TechhouseDragon/NC-1-/PCB/Button/Project Outputs for button/BOM/Bill of Materials-button.xls

Description | Designator | Comment | Value | Footprint | Quantity | Supplier 1 | Supplier Part Number 1 | Pricing 1 | Manufacturer 1 | Manufacturer Part Number 1
CAP CER 0.1UF 50V X5R 0603 | CL1, CL2, CL3, CL4, CL5, CL6, CL7, CL8, CL9, CL10 | 603 | 0.1uF | C0603 | 10 | Digi-Key | 311-4046-1-ND | 1=0.10000, 10=0.05600, 50=0.03080, 100=0.02510, 500=0.01794, 1000=0.01410 (USD) | Yageo | CC0603KRX5R9BB104
Pushbutton Switch SPDT Keyswitch, Illuminated Through Hole | PAT1, PAT2, PAT3, PAT4, PAT5, PAT6, PAT7, PAT8, PAT9, PAT10 | 55?-2LED01 |  | 5501-2LED | 10 | Digi-Key | EG171571-ND | 1=5.08000, 10=4.53000, 25=4.28800, 50=4.13420, 100=3.93620, 250=3.76028, 500=3.43044, 1000=3.25452 (USD) | E-Switch | 5501MBLKREDGRN
RES SMD 330 OHM 1% 1/10W 0603 | RL1, RL2, RL3, RL4, RL5, RL6, RL7, RL8, RL9, RL10, RL11, RL12, RL13, RL14, RL15, RL16, RL17, RL18, RL19, RL20 | 603 | 330 | R0603 | 20 | Digi-Key | 311-330HRCT-ND | 1=0.10000, 10=0.02300, 100=0.00940, 1000=0.00421, 2500=0.00366 (USD) | Yageo | RC0603FR-07330RL
