TechhouseDragon/NC-1-/PCB/STROBE/Project Outputs for Strobe/BOM/Bill of Materials-Strobe.xls

Description | Designator | Comment | Value | Footprint | Quantity | Supplier 1 | Supplier Part Number 1 | Pricing 1 | Manufacturer 1 | Manufacturer Part Number 1
Pushbutton Switch SPST-NO Standard, Illuminated Through Hole | BTN | KP0115ANBKG03RGB-2SJB |  | KP0115ANBKG03RGB-2SJB | 1 | Digi-Key | 360-2465-ND | 1=20.27000, 10=18.40500, 25=17.57800, 50=16.64740, 100=16.02700, 250=14.99300, 500=12.40800 (USD) | NKK Switches | KP0115ANBKG03RGB-2SJB
CAP CER 0.1UF 50V X5R 0603 | C1 | 603 | 0.1uF | C0603 | 1 | Digi-Key | 311-4046-1-ND | 1=0.10000, 10=0.05600, 50=0.03080, 100=0.02510, 500=0.01794, 1000=0.01410 (USD) | Yageo | CC0603KRX5R9BB104
CONN HEADER VERT 6POS 2.54MM | P | Header 6 |  | Molex HDR1X6 | 1 | Digi-Key | WM4204-ND | 1=0.43000, 10=0.40300, 100=0.28180, 500=0.24150, 1000=0.20125, 5000=0.17250, 10000=0.16100 (USD) | Molex | 22-23-2061
RES SMD 330 OHM 1% 1/10W 0603 | R1 | 603 | 330 | R0603 | 1 | Digi-Key | 311-330HRCT-ND | 1=0.10000, 10=0.02300, 100=0.00940, 1000=0.00421, 2500=0.00366 (USD) | Yageo | RC0603FR-07330RL
