TechhouseDragon/NC-1-/PCB/Toggle/Project Outputs for Toggle/BOM/Bill of Materials-Toggle.xls

Description | Designator | Comment | Value | Footprint | Quantity | Supplier 1 | Supplier Part Number 1 | Pricing 1 | Manufacturer 1 | Manufacturer Part Number 1
CONN HEADER VERT 3POS 2MM | P | Header 3 |  | B3B-PH-K-S(LF)(SN) | 1 | Digi-Key | 455-1705-ND | 1=0.19000, 10=0.18200, 100=0.12620, 500=0.10676, 1000=0.08736, 5000=0.07765, 10000=0.07037 (USD) | JST | B3B-PH-K-S(LF)(SN)
SWITCH TOGGLE SPDT 6A 125V | TOGGLE | 5636AB9 |  | 320-916 | 1 | Mouser | 642-5636A9 | 1=8.04000, 25=7.62000, 50=7.19000, 100=6.98000, 250=5.92000, 500=5.71000 (USD) | APEM | 5636A9
