TechhouseDragon/NC-1-/PCB/LEDController_NC-1/Project Outputs for LEDController_NC-1/BOM/Bill of Materials-LEDController_NC-1.xls

Description | Designator | Comment | Value | Footprint | Quantity | Supplier 1 | Supplier Part Number 1 | Pricing 1 | Manufacturer 1 | Manufacturer Part Number 1 | Supplier Unit Price 1 | Manufacturer Part Number | Manufacturer
CONN HEADER VERT 8POS 2.54MM | AD_H | AD_H |  | Header 8x1 8.5mm | 1 | Digi-Key | S1212EC-08-ND | 1=0.22000, 10=0.20200, 25=0.17200, 50=0.15060, 100=0.13980, 250=0.12364, 500=0.11828 (USD) | Sullins | PREC008SFAN-RC | 0.22
CONN HEADER VERT 8POS 2.54MM | AD_L | AD_L |  | Header 8x1 8.5mm | 1 | Digi-Key | S1212EC-08-ND | 1=0.22000, 10=0.20200, 25=0.17200, 50=0.15060, 100=0.13980, 250=0.12364, 500=0.11828 (USD) | Sullins | PREC008SFAN-RC | 0.22
CONN HEADER VERT 3POS 2MM | BLACKOUT, COLOR_MODE | Header 3 |  | B3B-PH-K-S(LF)(SN) | 2 | Digi-Key | 455-1705-ND | 1=0.19000, 10=0.18200, 100=0.12620, 500=0.10676, 1000=0.08736, 5000=0.07765, 10000=0.07037 (USD) | JST | B3B-PH-K-S(LF)(SN) | 0.19
CAP CER 0.1UF 50V X5R 0603 | CB1, CL11, CL12, CL13, CR1, CR2, CR3 | 603 | 0.1uF | C0603 | 7 | Digi-Key | 311-4046-1-ND | 1=0.10000, 10=0.05600, 50=0.03080, 100=0.02510, 500=0.01794, 1000=0.01410 (USD) | Yageo | CC0603KRX5R9BB104 | 0.1
CONN HEADER VERT 8POS 2.54MM | COMMS | Communication |  | Header 8x1 8.5mm | 1 | Digi-Key | S1212EC-08-ND | 1=0.22000, 10=0.20200, 25=0.17200, 50=0.15060, 100=0.13980, 250=0.12364, 500=0.11828 (USD) | Sullins | PREC008SFAN-RC | 0.22
CAP ALUM 220UF 20% 35V SMD | CP1, CP2, CP3, CP4 | Cap Pol | 220uF | Cap10x10 | 4 | Digi-Key | 4427PHCT-ND | 1=2.42000, 10=1.95700, 50=1.70800, 100=1.49460 (USD) | Vishay BCcomponents | MAL214699004E3 | 2.53
CONN HEADER VERT 36POS 2.54MM | DIGITAL | IO_36 |  | HEADER 36X 8MM | 1 | Digi-Key | S2212EC-18-ND | 1=0.77000, 10=0.72600, 25=0.65320, 50=0.58060, 100=0.55640, 250=0.50804, 500=0.48384 (USD) | Sullins | PREC018DFAN-RC | 0.77
DIODE SCHOTTKY 40V 3A SOD123FA | DP1, DP2 | SS34FA |  | SOD_34FA_ONS | 2 | Digi-Key | SS34FACT-ND | 1=0.35000, 10=0.28200, 25=0.25800, 100=0.16200, 500=0.15000, 1000=0.10200 (USD) | ON Semiconductor / Fairchild | SS34FA | 0.49
 | ICSP | ICSP |  | ICSP | 1
2.0 x 6.0 mm, 5.0 A, Horizontal, Through Hole, Pick-n-Place Top, Dc Power Jack Connector | JIN | PJ-050AH |  | CUI_PJ-050AH | 1 | Digi-Key | CP-050AH-ND | 1=0.78000, 10=0.68900, 25=0.64800, 50=0.62100, 100=0.59400, 250=0.54000, 500=0.48600, 1000=0.43200, 2500=0.39150 (USD) | CUI | PJ-050AH | 0.79
LED RED DIFFUSED T-1 3/4 T/H | LED1, LED2, LED3, LED4, LED5, LED6, LED7, LED8, LED9, LED10, LED11, LED12, LED13, LED14, LED15, LED16, LED17, LED18, LED19, LED20 | LED 3mm |  | LED3mm | 20 | Digi-Key | 754-1264-ND | 1=0.48000, 10=0.34200, 100=0.15200, 500=0.10640, 1000=0.08740, 2500=0.07600, 5000=0.06840, 10000=0.06080, 25000=0.05700 (USD) | Kingbright | WP7113ID | 0.278
Amber 605nm LED Indication - Discrete 2V 0603 (1608 Metric) | LEDP1, LEDP2, LEDP3, LEDP4, LEDP5, LEDP6, LEDP7 | 150060AS75000 |  | LED-0603-Amber | 7 | Digi-Key | 732-150060AS75000CT-ND | 1=0.14000, 50=0.13300, 100=0.11400, 500=0.09900 (USD) | Wurth Electronics | 150060AS75000 | 0.14
FIXED IND 47UH 3.8A 60 MOHM SMD | LP1, LP2 | 12x12mm | 47uH | 12x12mmInductor | 2 | Digi-Key | 732-1246-1-ND | 1=2.41000, 10=2.20000, 50=2.07000, 100=1.94000 (USD) | Wurth Electronics | 7447709470 | 2.41
CONN HEADER VERT 12POS 2.54MM | P1 | Header 12 |  | 12Pos Header | 1 | Digi-Key | S1212EC-12-ND | 1=0.30000, 10=0.28200, 25=0.24200, 50=0.20560, 100=0.19760, 250=0.17740, 500=0.16934 (USD) | Sullins | PREC012SFAN-RC | 0.3
CONN HEADER VERT 10POS 2.54MM | P2, P3 | Header 10 |  | 10POS HEADER | 2 | Digi-Key | S1212EC-10-ND | 1=0.27000, 10=0.25200, 25=0.21520, 50=0.18820, 100=0.17470, 250=0.15456, 500=0.14784 (USD) | Sullins | PREC010SFAN-RC | 0.27
CONN HEADER VERT 6POS 2.54MM | P_JUMPER | Header 3X2 |  | HDR2X3 | 1 | Digi-Key | S2212EC-03-ND | 1=0.16000, 10=0.15100, 25=0.12920, 50=0.11280, 100=0.10480, 250=0.09272, 500=0.08870 (USD) | Sullins | PREC003DFAN-RC | 0.16
CONN HEADER VERT 6POS 2.54MM | P_LED1 | Header 6 |  | HDR1X6 | 1 | Digi-Key | S1212EC-06-ND | 1=0.16000, 10=0.15100, 25=0.12920, 50=0.11280, 100=0.10480, 250=0.09272, 500=0.08870 (USD) | Sullins | PREC006SFAN-RC | 0.16
CONN MOD JACK 6P6C R/A UNSHLD | P_LED2 | E5566-Q0LK22-L |  | E5566Q0LK22L | 1 | Digi-Key | 553-2258-ND | 1=0.54000, 10=0.51000, 25=0.45920, 50=0.40800, 100=0.39100, 250=0.35700, 500=0.34000, 1000=0.28050, 2500=0.25500 (USD) | Pulse | E5566-Q0LK22-L | 0.58
Pushbutton Switch SPST-NO Standard, Illuminated Through Hole | Pallete | KP0115ANBKG03RGB-2SJB |  | KP0115ANBKG03RGB-2SJB | 1 | Digi-Key | 360-2465-ND | 1=20.27000, 10=18.40500, 25=17.57800, 50=16.64740, 100=16.02700, 250=14.99300, 500=12.40800 (USD) | Nihon Kaiheiki | KP0115ANBKG03RGB-2SJB | 20.47
TERMINAL BLOCK, SCREW TYPE, 5.08 | PIN | Header 2 |  | 5.08mmScrew | 1 | Digi-Key | 102-6203-ND | 1=0.73000, 10=0.39800, 25=0.29760, 50=0.26520, 100=0.26000, 250=0.22880, 500=0.20800, 1000=0.18720, 5000=0.14040 (USD) | CUI | TB007-508-02BE | 0.79
CONN HEADER VERT 6POS 2.54MM | POWER | POWER |  | Header 6x1 8.5mm | 1 | Digi-Key | S1212EC-06-ND | 1=0.16000, 10=0.15100, 25=0.12920, 50=0.11280, 100=0.10480, 250=0.09272, 500=0.08870 (USD) | Sullins | PREC006SFAN-RC | 0.16
Red, Yellow 617nm Red, 588nm Yellow LED Indication - Discrete 2V Red, 2.1V Yellow Radial - 3 Leads | POWER_INDICATOR | WP59EYW |  | DUOLED-C-5MM | 1 | Digi-Key | 754-1233-ND | 1=0.62000, 10=0.44600, 100=0.29120, 500=0.20930, 1000=0.16380, 2500=0.15015, 5000=0.13650, 10000=0.12740, 25000=0.12285 (USD) | Kingbright | WP59EYW | 0.63
CONN HEADER VERT 8POS 2.54MM | PWM_H | PWM_H |  | Header 8x1 8.5mm | 1 | Digi-Key | S1212EC-08-ND | 1=0.22000, 10=0.20200, 25=0.17200, 50=0.15060, 100=0.13980, 250=0.12364, 500=0.11828 (USD) | Sullins | PREC008SFAN-RC | 0.22
CONN HEADER VERT 8POS 2.54MM | PWM_L | PWM_L |  | Header 8x1 8.5mm | 1 | Digi-Key | S1212EC-08-ND | 1=0.22000, 10=0.20200, 25=0.17200, 50=0.15060, 100=0.13980, 250=0.12364, 500=0.11828 (USD) | Sullins | PREC008SFAN-RC | 0.22
Bipolar (BJT) Transistor NPN 25V 1.5A 100MHz 300mW Surface Mount SOT-23 | Q1 | SS8050-G |  | TRAN_SS8050-G_CIP | 1 | Digi-Key | 641-1790-1-ND | 1=0.21000, 10=0.17400, 25=0.14600, 100=0.07130, 500=0.05946, 1000=0.04131 (USD) | Comchip | SS8050-G | 0.26
Potentiometers Sgl Unit Vert Flat Snap-in 10K Ohms 20% | R1, R2, R3, R4, R5, R6, R7, R8 | RK09L1140A2U |  | EVUFXM | 8 | Mouser | 688-RK09L1140A2U | 1=1.49000, 25=1.31000, 50=1.23000, 100=1.19000, 500=1.10000, 1000=1.07000 (USD) | Alps Electric | RK09L1140A2U | 1.49
RES SMD 330 OHM 1% 1/10W 0603 | RB1, RL22, RL23, RP1, RP2, RP3, RP4, RP5, RP6, RP7, RR21, RR22, RR23, RR24, RR25, RR26, RR27, RR28, RR29, RR30, RR31, RR32, RR33, RR34, RR35, RR36, RR37, RR38, RR39, RR40 | 603 | 330 | R0603 | 30 | Digi-Key | 311-330HRCT-ND | 1=0.10000, 10=0.02300, 100=0.00940, 1000=0.00421, 2500=0.00366 (USD) | Yageo | RC0603FR-07330RL | 0.024
RES SMD 10K OHM 5% 1/10W 0603 | RL24, RL25, RL26, RL27, RL28, RL29 | 603 | 10K | R0603 | 6 | Digi-Key | 311-10KGRCT-ND | 1=0.10000, 10=0.01900, 100=0.00770, 1000=0.00347, 2500=0.00301 (USD) | Yageo | RC0603JR-0710KL | 0.1
Switch Rotary SP Flatted Shaft PC Pins 0.2A 115VAC 30VDC | ROTARY1, ROTARY2 | 56DP36-01-1-AJN |  | 56DP36-01-1-AJN | 2 | Digi-Key | GH7281-ND | 1=12.16000, 5=10.45800, 10=9.77800, 25=8.96720, 50=8.36600, 100=7.84320, 250=7.29600 (USD) | Grayhill | 56DP36-01-1-AJN | 12.16
RES SMD 1K OHM 1% 1/10W 0603 | RP, RR1, RR2, RR3, RR4, RR5, RR6, RR7, RR8, RR9, RR10, RR11, RR12, RR13, RR14, RR15, RR16, RR17, RR18, RR19, RR20 | 603 | 1K | R0603 | 21 | Digi-Key | 311-1.00KHRDKR-ND | 1=0.10000, 10=0.02300, 100=0.00940, 1000=0.00421, 2500=0.00366 (USD) | Mepco Philips | RC0603FR-071KL | 0.024 | RC0603FR-071KL | Yageo
CONN HEADER VERT 4POS 2.54MM | SP_SELECTOR | SPEEDSELECTOR |  | HDR1X4 | 1 | Digi-Key | S1212EC-04-ND | 1=0.13000, 10=0.12600, 25=0.09400, 50=0.08060, 100=0.07800, 250=0.06720, 500=0.06452 (USD) | Sullins | PREC004SFAN-RC | 0.13
Connector Header Through Hole 2 position 0.079" (2.00mm) | STROBE | STROBE |  | JST_B2B-PH-K-S(LF)(SN) | 1 | Newark | 37K9940 | 1=0.183000, 10=0.172000, 100=0.123000, 500=0.104000, 1000=0.087000, 5000=0.075000 (USD) | JST | B2B-PH-K-S(LF)(SN) | 0.227
Counter Shift Registers 8-Bit Shift Register | U1, U2, U3, U4, U5, U6 | SN74HC595NE4 |  | DIP794W53P254L1930H508Q16N | 6 | Digi-Key | 296-36142-5-ND | 1=0.57000, 10=0.48800, 25=0.45520, 100=0.36400, 250=0.33800, 500=0.28600, 1000=0.22100, 2500=0.20150, 5000=0.18850 (USD) | Texas Instruments | SN74HC595NE4 | 0.65
Buck Switching Regulator IC Positive Fixed 5V 1 Output 3A TO-263-6, D²Pak (5 Leads + Tab), TO-263BA | U7 | LM2596SX-5.0/NOPB | Value | TS5B | 1 | Digi-Key | LM2596SX-5.0/NOPBCT-ND | 1=4.91000, 10=4.41300, 25=4.17160, 100=3.42990, 250=3.07764 (USD) | TI National Semiconductor | LM2596SX-5.0/NOPB | 5.06
Buck Switching Regulator IC Positive Fixed 12V 1 Output 3A TO-263-6, D²Pak (5 Leads + Tab), TO-263BA | U8 | LM2596SX-12.0 |  | TS5B | 1 | Digi-Key | LM2596SX-12/NOPBCT-ND | 1=4.77000, 10=4.28400, 25=4.05000, 100=3.33000, 250=2.98800 (USD) | TI National Semiconductor | LM2596SX-12/NOPB | 5.06
