TechhouseDragon/NC-1-/Enclosure/pcb.DXF

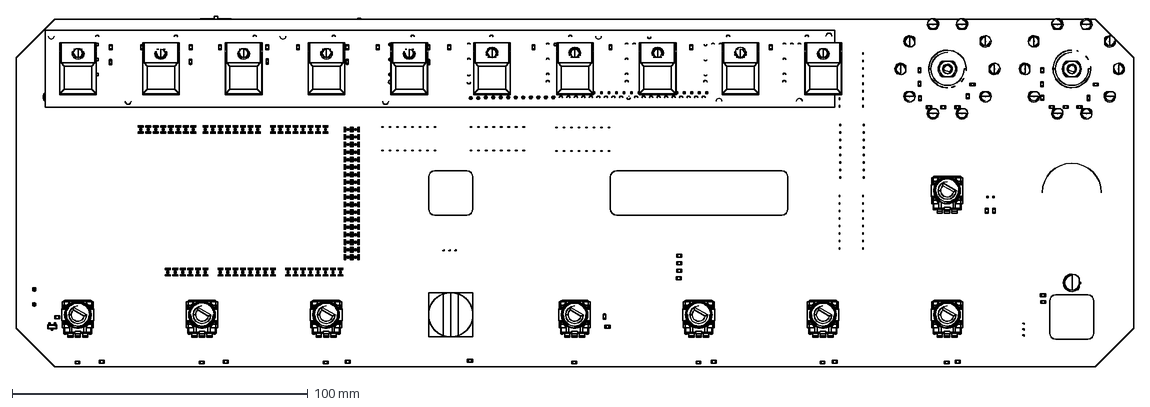
[picture p1: CAD file, 2022-05-18]
Enclosure/pcb.DXF
377.8 x 118.4 mm
