TechhouseDragon/NC-1-/PCB/Button/Project Outputs for button/3D STEP/button.step

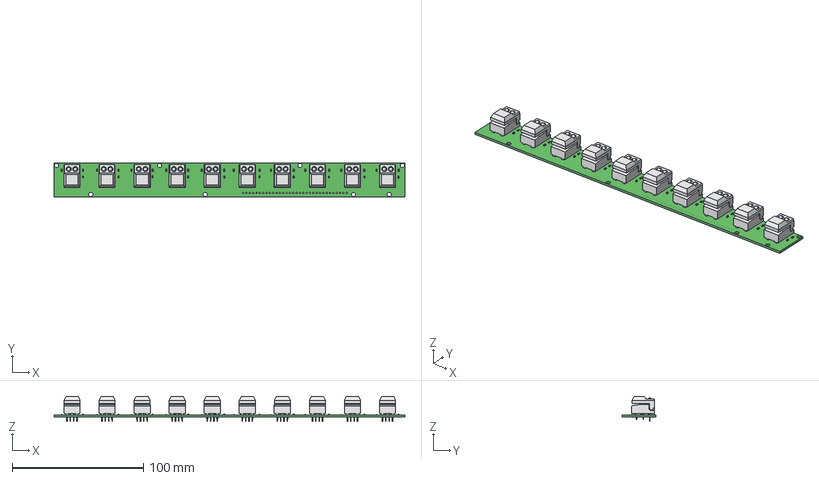
[picture p2: CAD file, 2022-05-08]
PCB/Button/Project Outputs for button/3D STEP/button.step
267.0 x 26.0 x 19.1 mm
RES_0603_(1608_metric) x 20
User_Library-CerCaps_0603 x 10
5501MBLKxxxxxx x 10
