TechhouseDragon/NC-1-/PCB/STROBE/Project Outputs for Strobe/3D STEP/Strobe.step

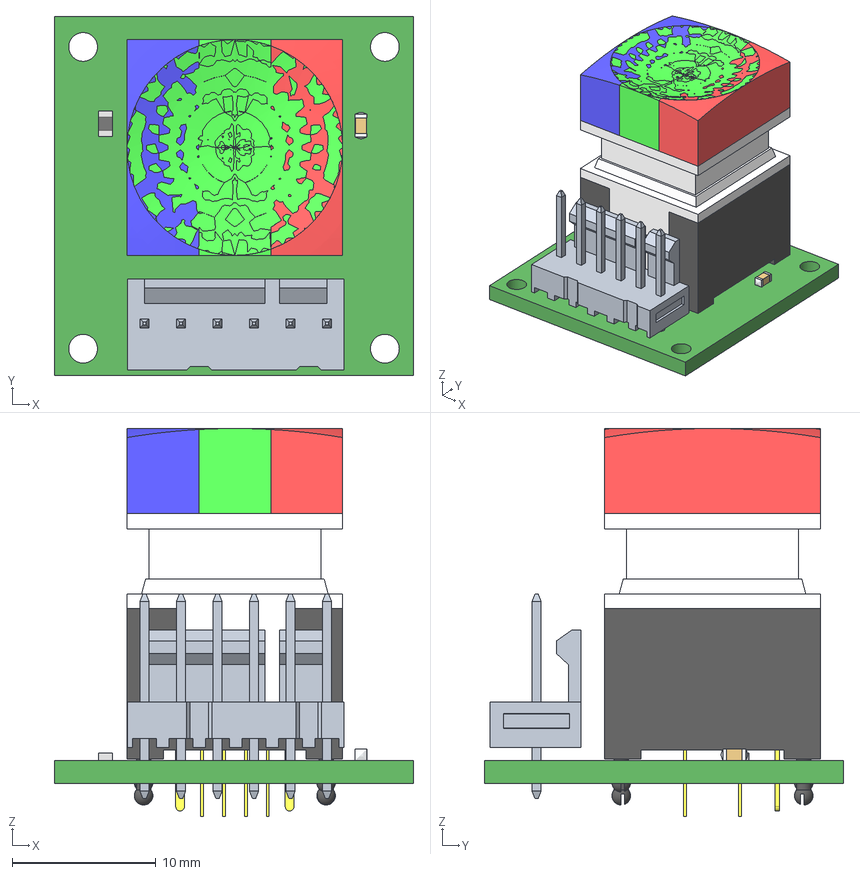
[picture p3: CAD file, 2022-05-08]
PCB/STROBE/Project Outputs for Strobe/3D STEP/Strobe.step
25.0 x 25.0 x 27.0 mm
RES_0603_(1608_metric)
User_Library-CerCaps_0603
_KP0115ANBKG03RGB2S
_kp_standard_coverB
_LED x 2
_LED2 x 8
_AT3079-GREEN-1/3
_AT3079-RED-1/3
_AT3079-BLUE-1/3
_block-2
