TechhouseDragon/NC-1-/PCB/Toggle/Project Outputs for Toggle/3D STEP/Toggle.step

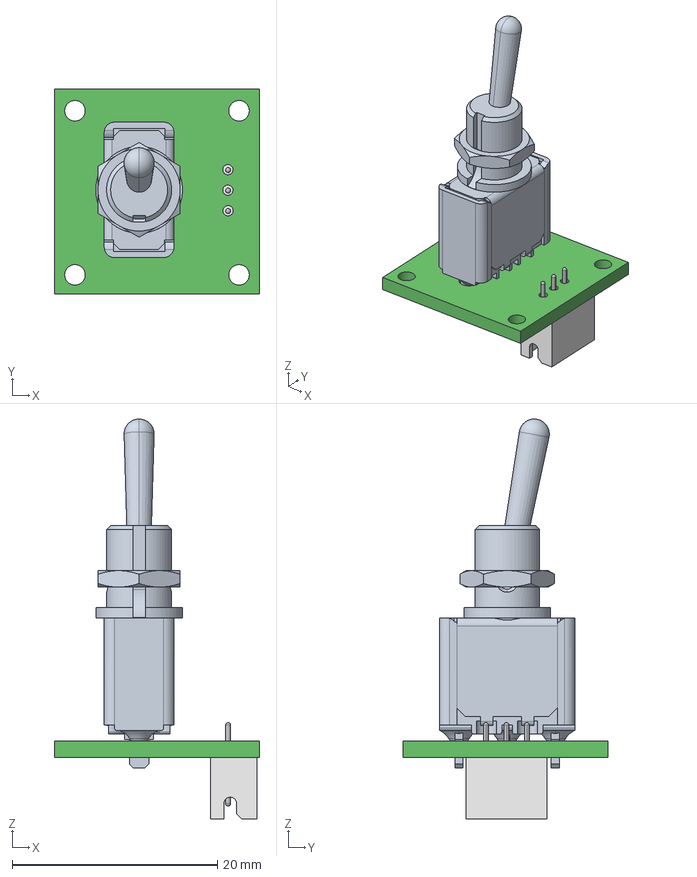
[picture p4: CAD file, 2022-05-08]
PCB/Toggle/Project Outputs for Toggle/3D STEP/Toggle.step
20.0 x 20.0 x 39.0 mm
5636ab
User_Library-B3B-PH-K-S(LF)(SN)
