TechhouseDragon/NC-1-/Enclosure/case.STEP

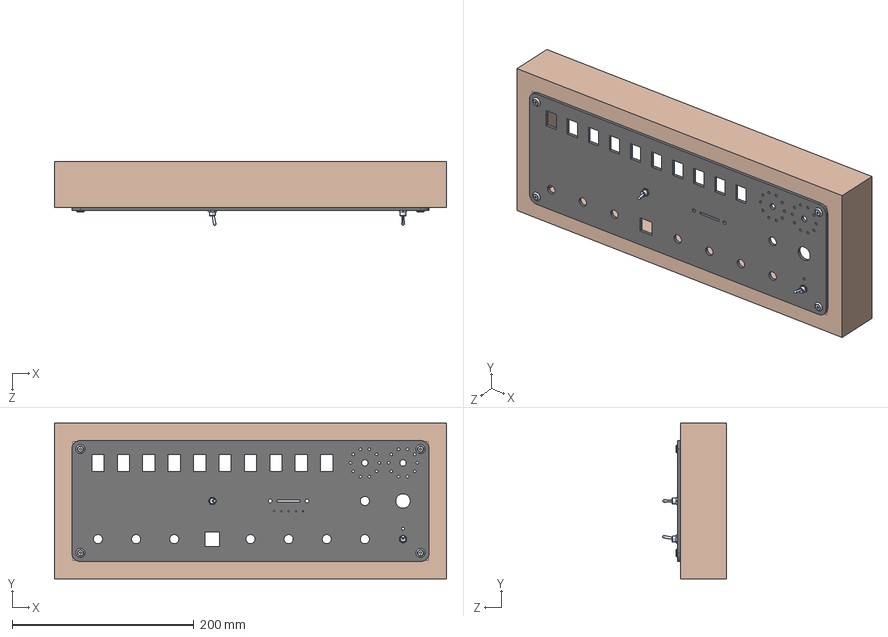
[picture p5: CAD file, 2022-05-18]
Enclosure/case.STEP
431.8 x 171.4 x 70.4 mm
5636ab.STEP x 2
98472A200_TYPE 18-8 STAINLESS STEEL COUNTERSUNK WASHER_98472A200.STEP x 4
92125A130_TYPE 18-8 SS FLAT-HEAD SOCKET CAP SCREW_92125A130.STEP x 4
front_panel_v2_R2.STEP
wood_frame.STEP
