TechhouseDragon/NC-1-/PCB/STROBE/Project Outputs for Strobe/Assembly/Assembly.PDF

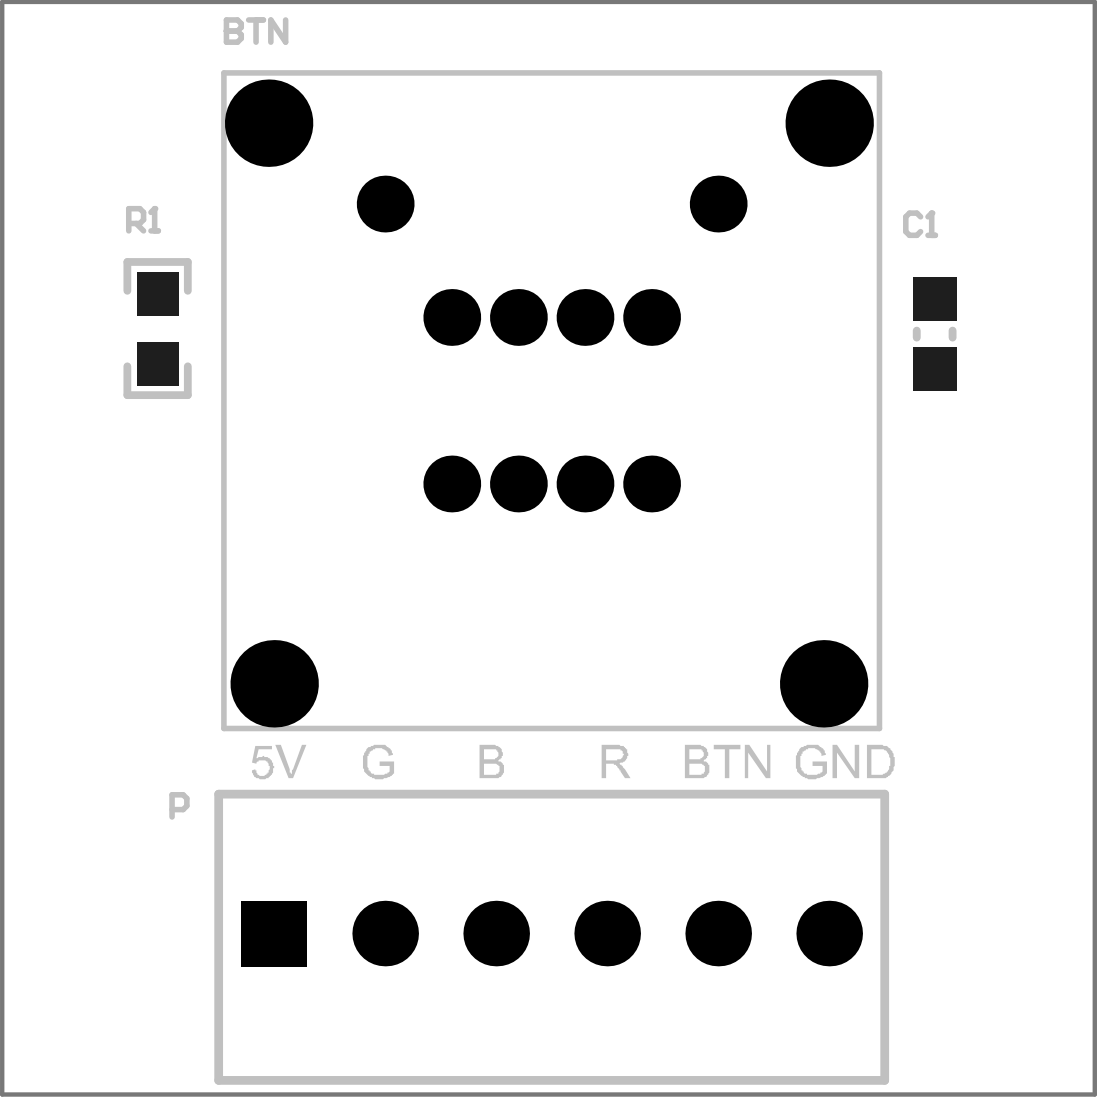
[picture p6: page 1]

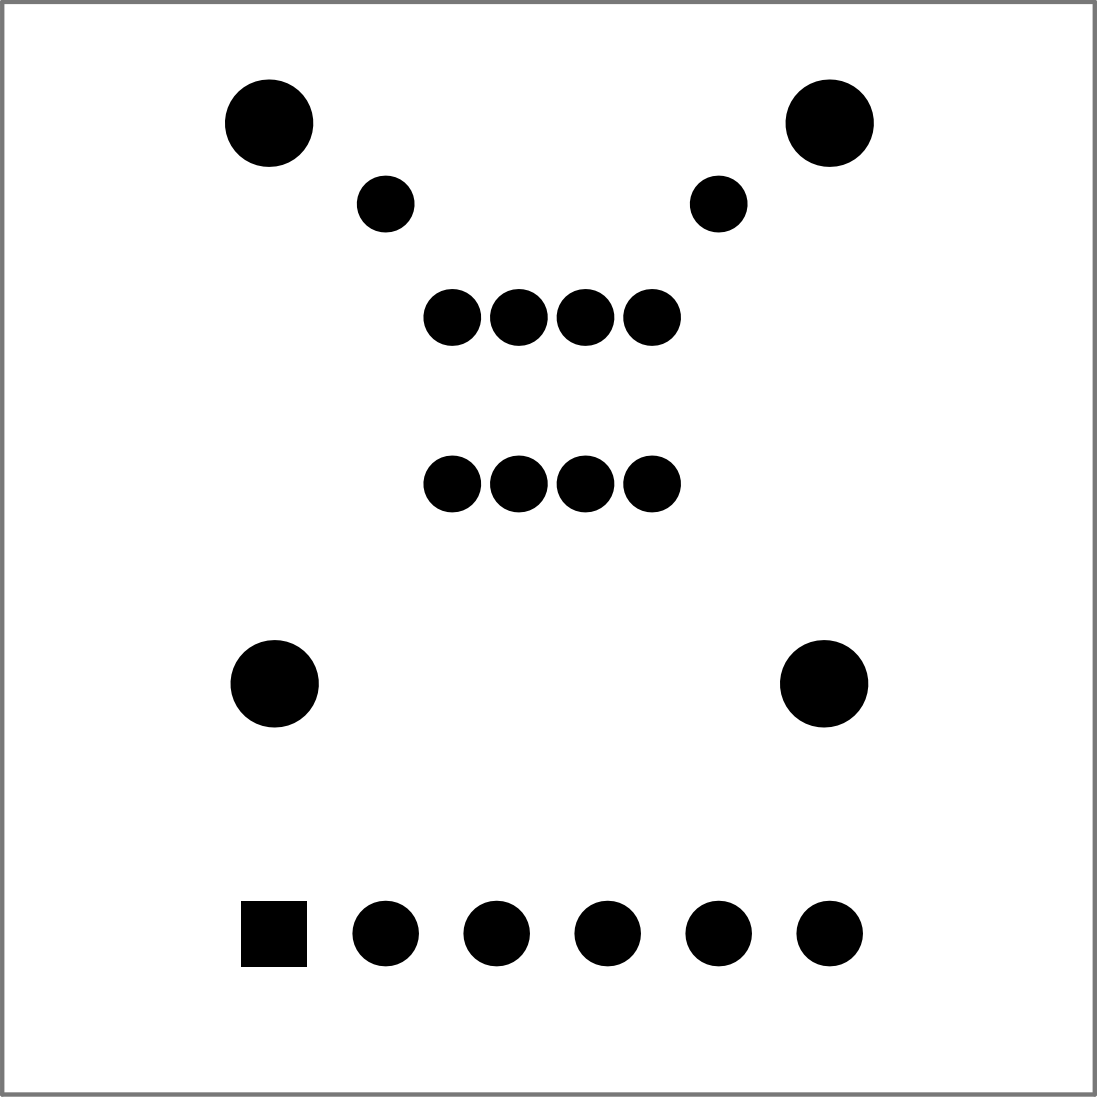
[picture p7: page 2]
