TechhouseDragon/NC-1-/PCB/Toggle/Project Outputs for Toggle/Assembly/Assembly.PDF

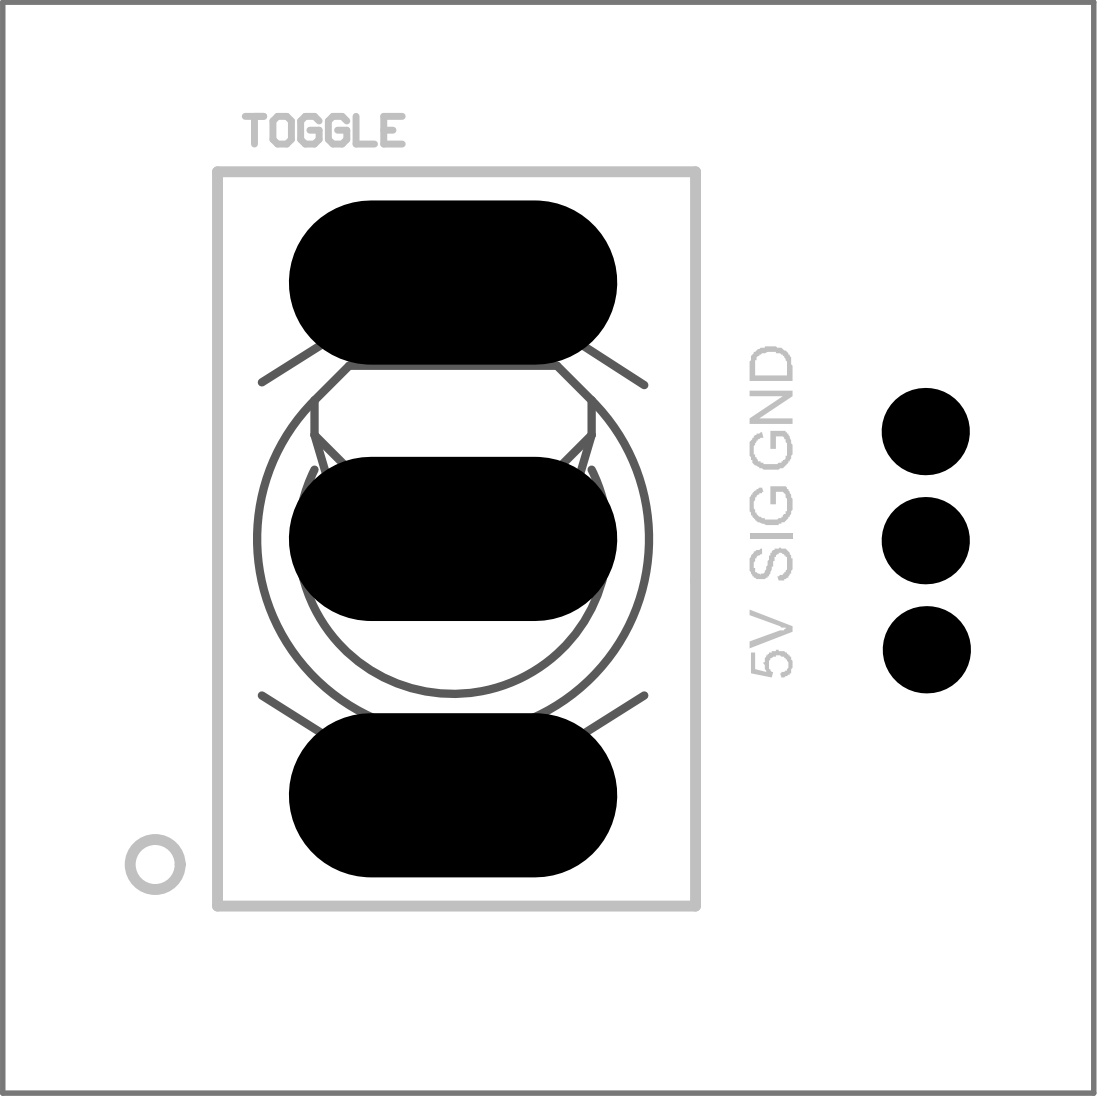
[picture p8: page 1]

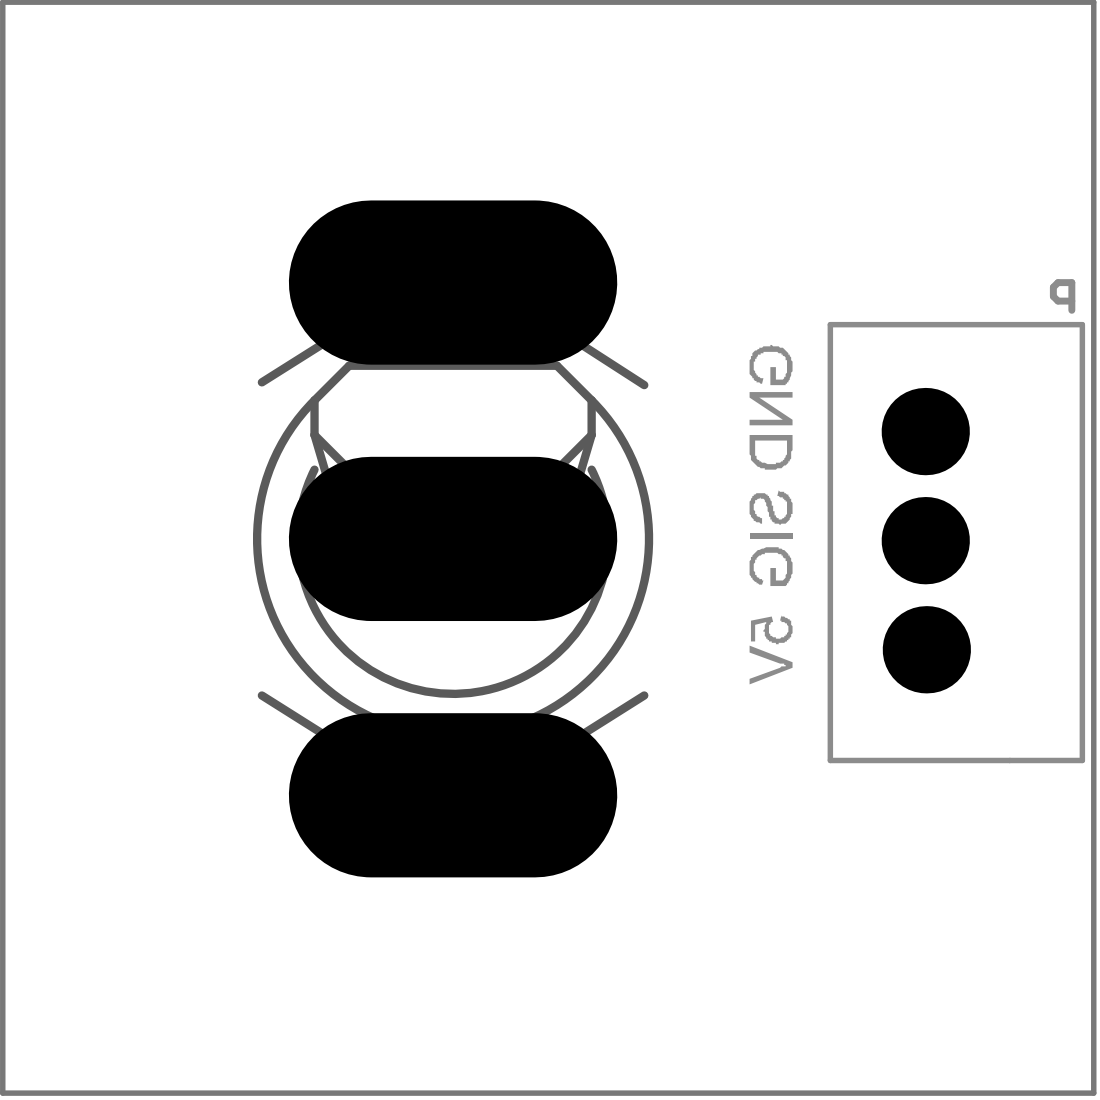
[picture p9: page 2]
