TechhouseDragon/NC-1-/PCB/LEDController_NC-1/Project Outputs for LEDController_NC-1/Assembly/Assembly.PDF

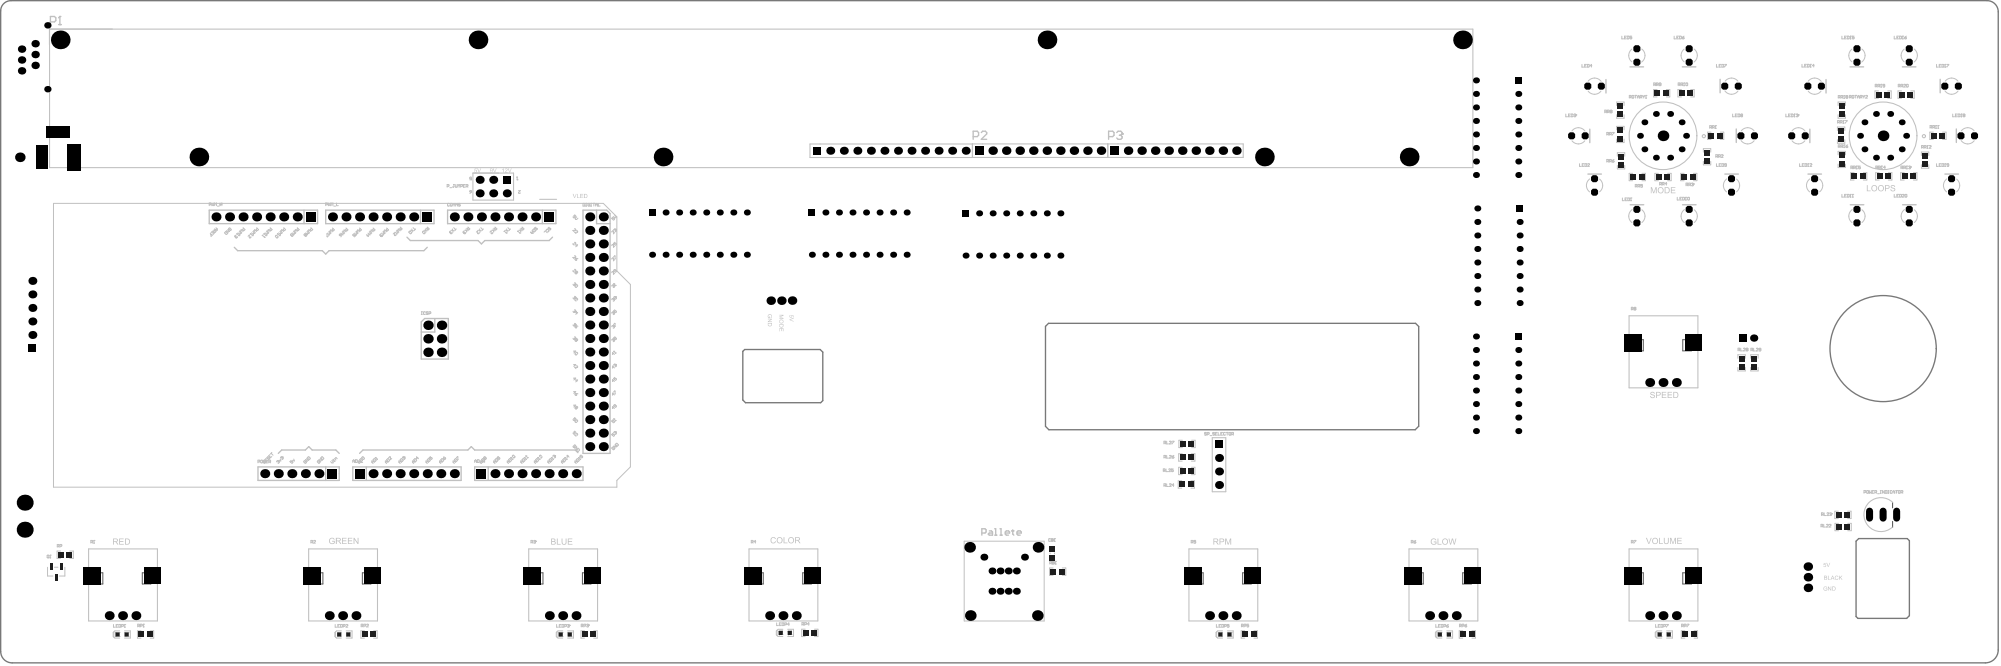
[picture p10: page 1]

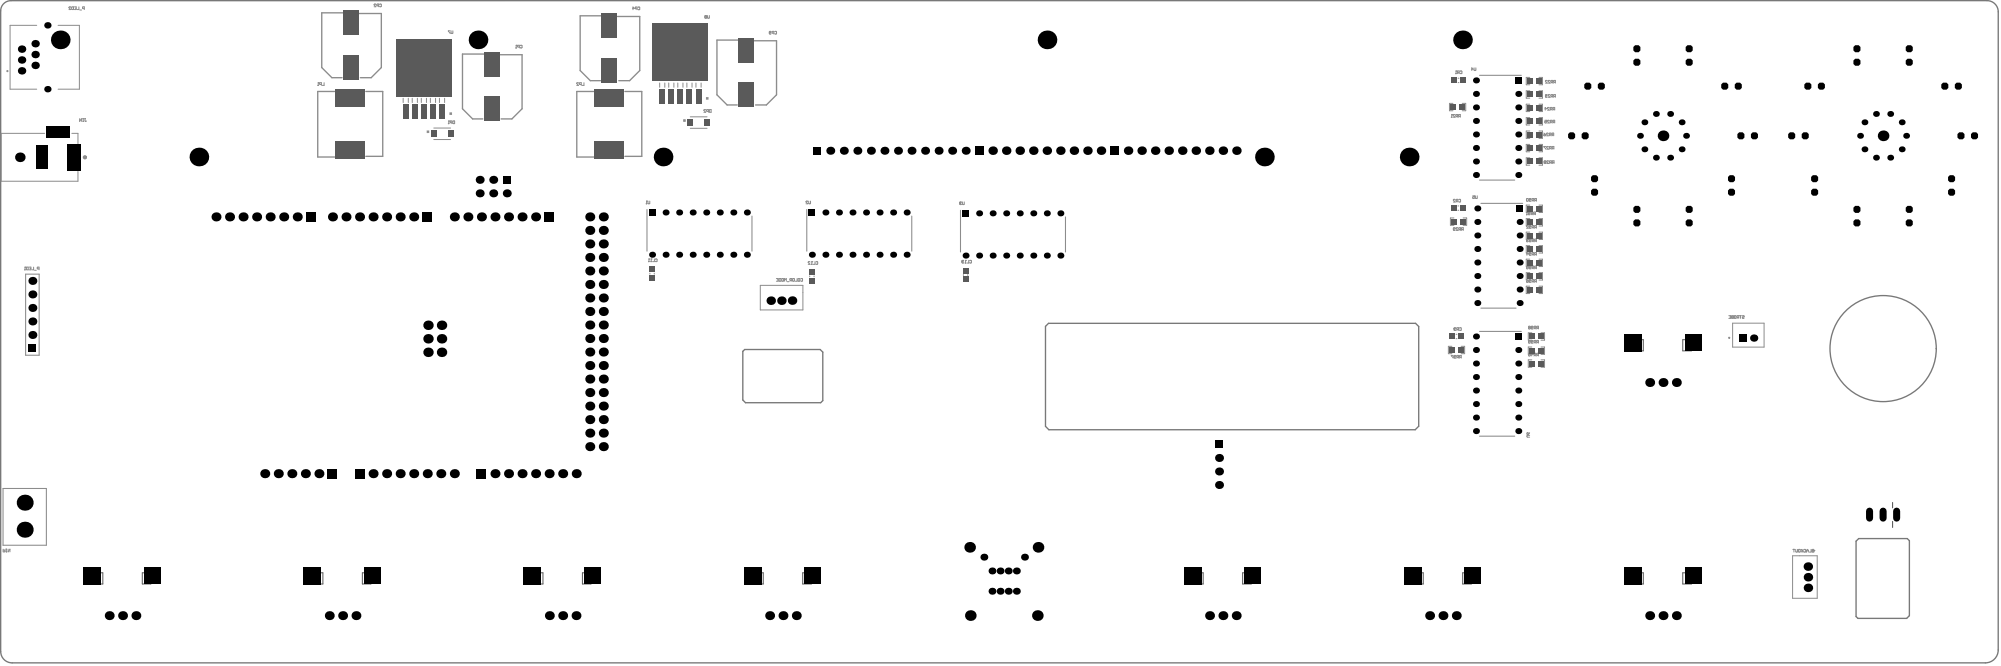
[picture p11: page 2]
