TechhouseDragon/NC-1-/NC_1_Front_Panel_Layout.pdf

## we have the night

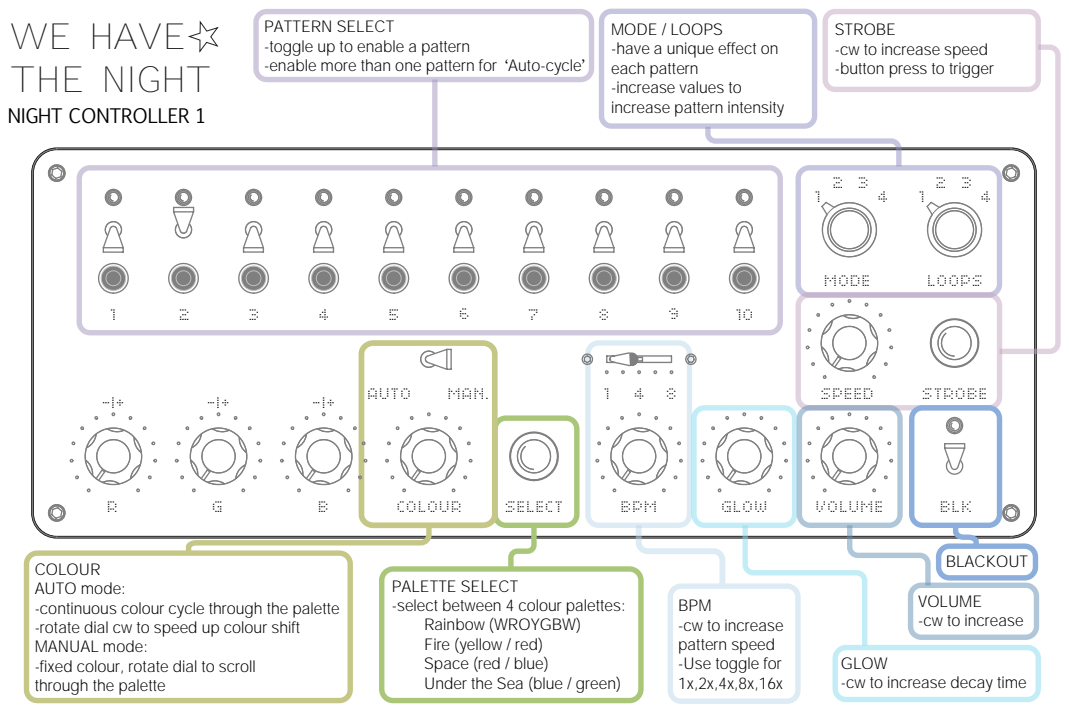
[picture p12: page 1]
COLOUR; SELECT; BPM; GLOW; VOLUME; BLK; MODE; LOOPS; AUTO; MAN. -|+; SPEED; STROBE; NIGHT CONTROLLER 1

PATTERN SELECT
-toggle up to enable a pattern
-enable more than one pattern for ‘Auto-cycle’

MODE / LOOPS
-have a unique effect on
each pattern
-increase values to
increase pattern intensity

STROBE
-cw to increase speed
-button press to trigger

BLACKOUT
VOLUME
-cw to increase

COLOUR
AUTO mode:
-continuous colour cycle through the palette
-rotate dial cw to speed up colour shift
MANUAL mode:
-fixed colour, rotate dial to scroll
through the palette

PALETTE SELECT
-select between 4 colour palettes:
Rainbow (WROYGBW)
Fire (yellow / red)
Space (red / blue)
Under the Sea (blue / green)

BPM
pattern speed
-Use toggle for

GLOW
-cw to increase decay time
