TechhouseDragon/NC-1-/PCB/Button/Project Outputs for button/SCH-PCB-3D Board PDF/SCH-PCB-3D Board.PDF

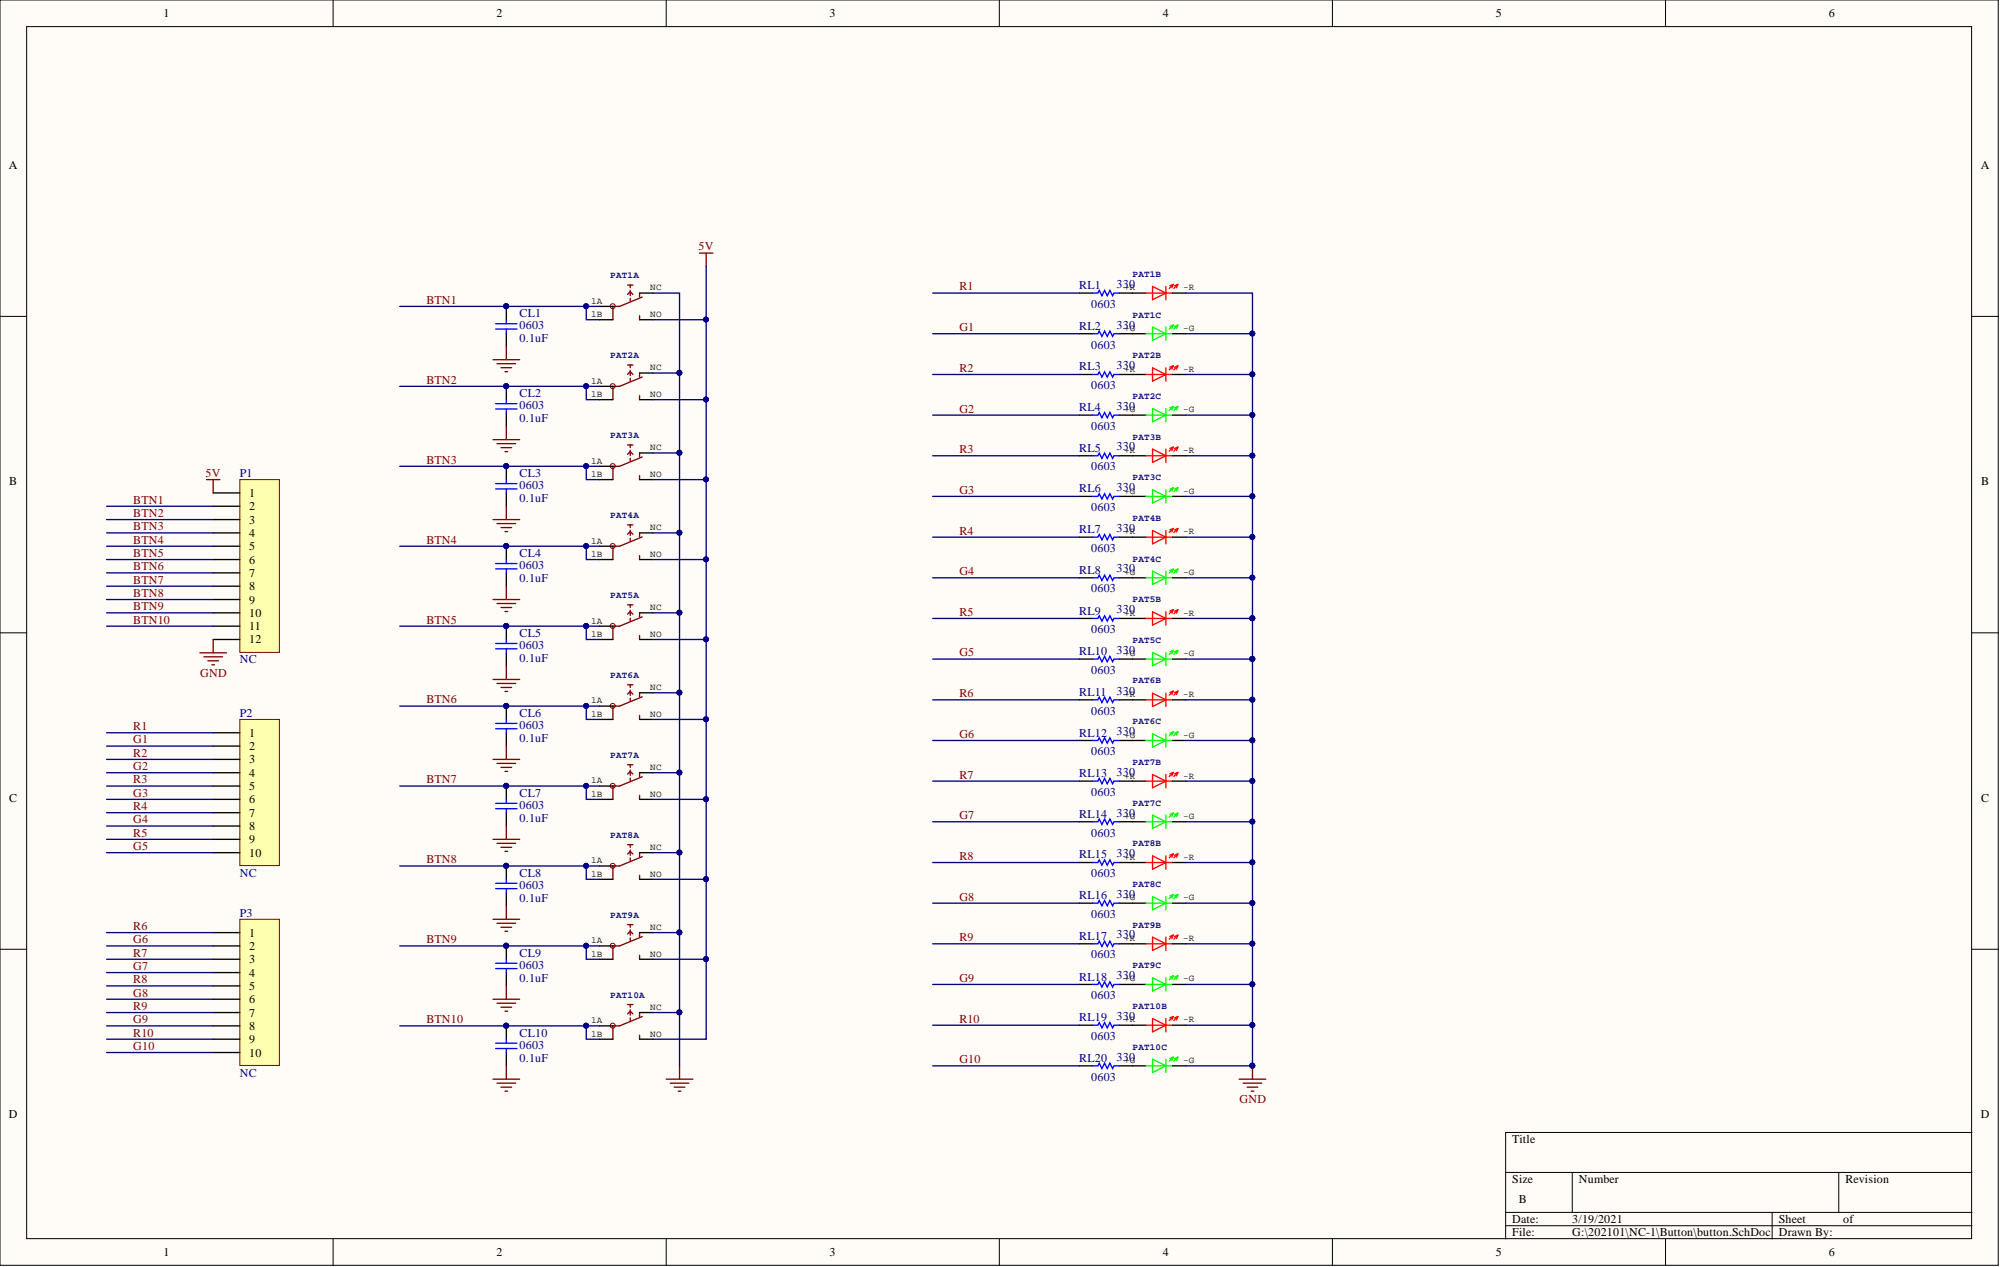
[picture p13: page 1]

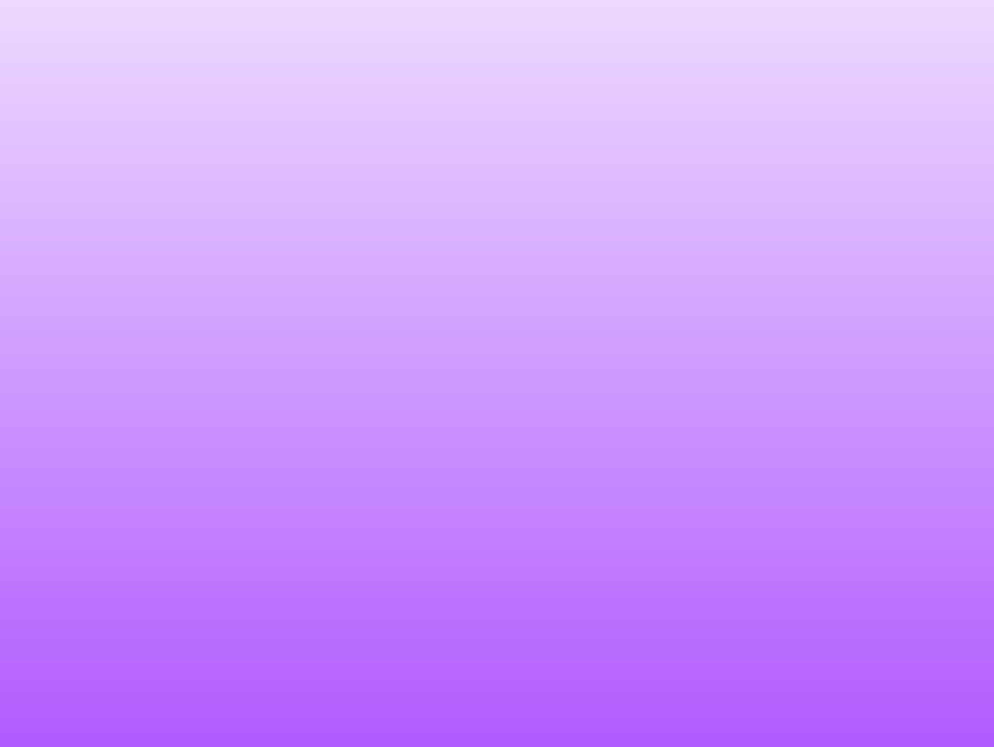
[picture p14: page 3]
