TechhouseDragon/NC-1-/PCB/STROBE/Project Outputs for Strobe/SCH-PCB-3D Board PDF/SCH-PCB-3D Board.PDF

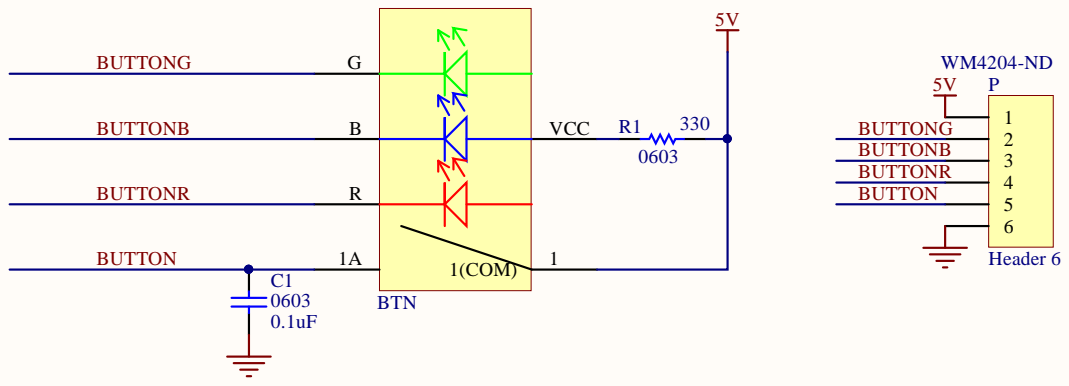
[picture p15: page 1]

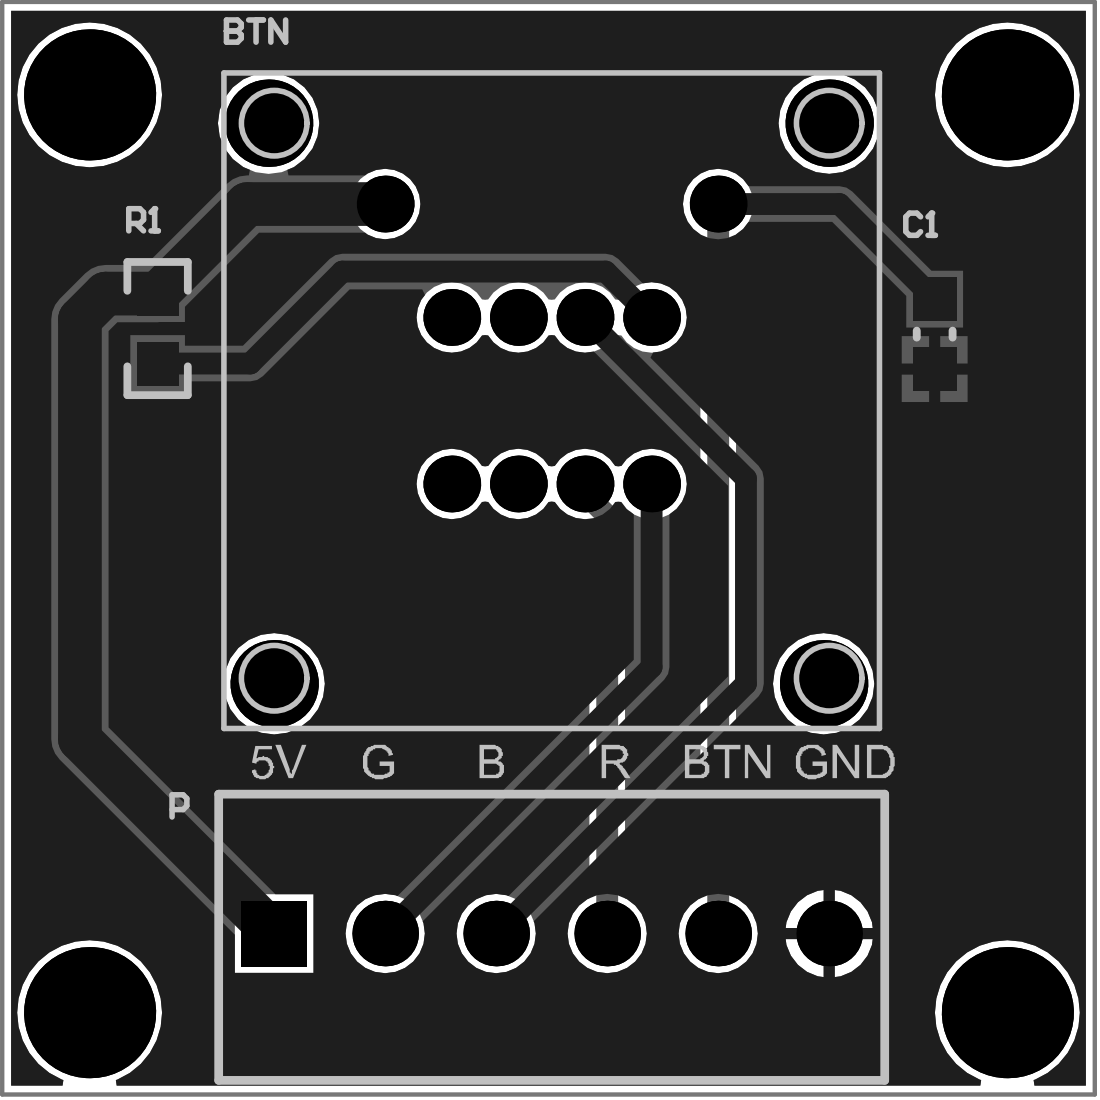
[picture p16: page 2]
