TechhouseDragon/NC-1-/PCB/Toggle/Project Outputs for Toggle/SCH-PCB-3D Board PDF/SCH-PCB-3D Board.PDF

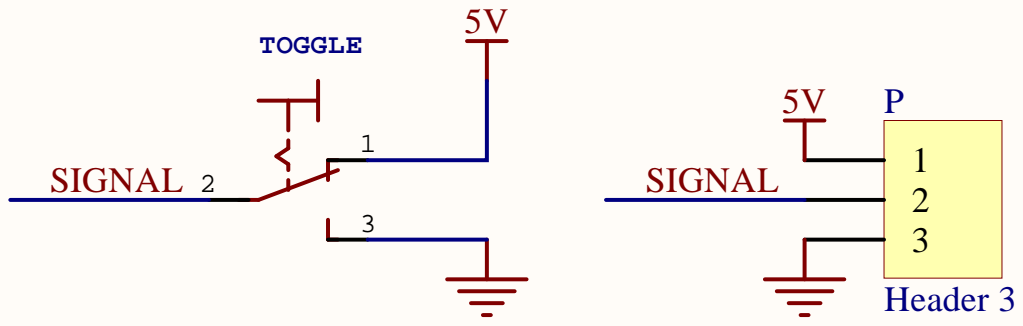
[picture p17: page 1]

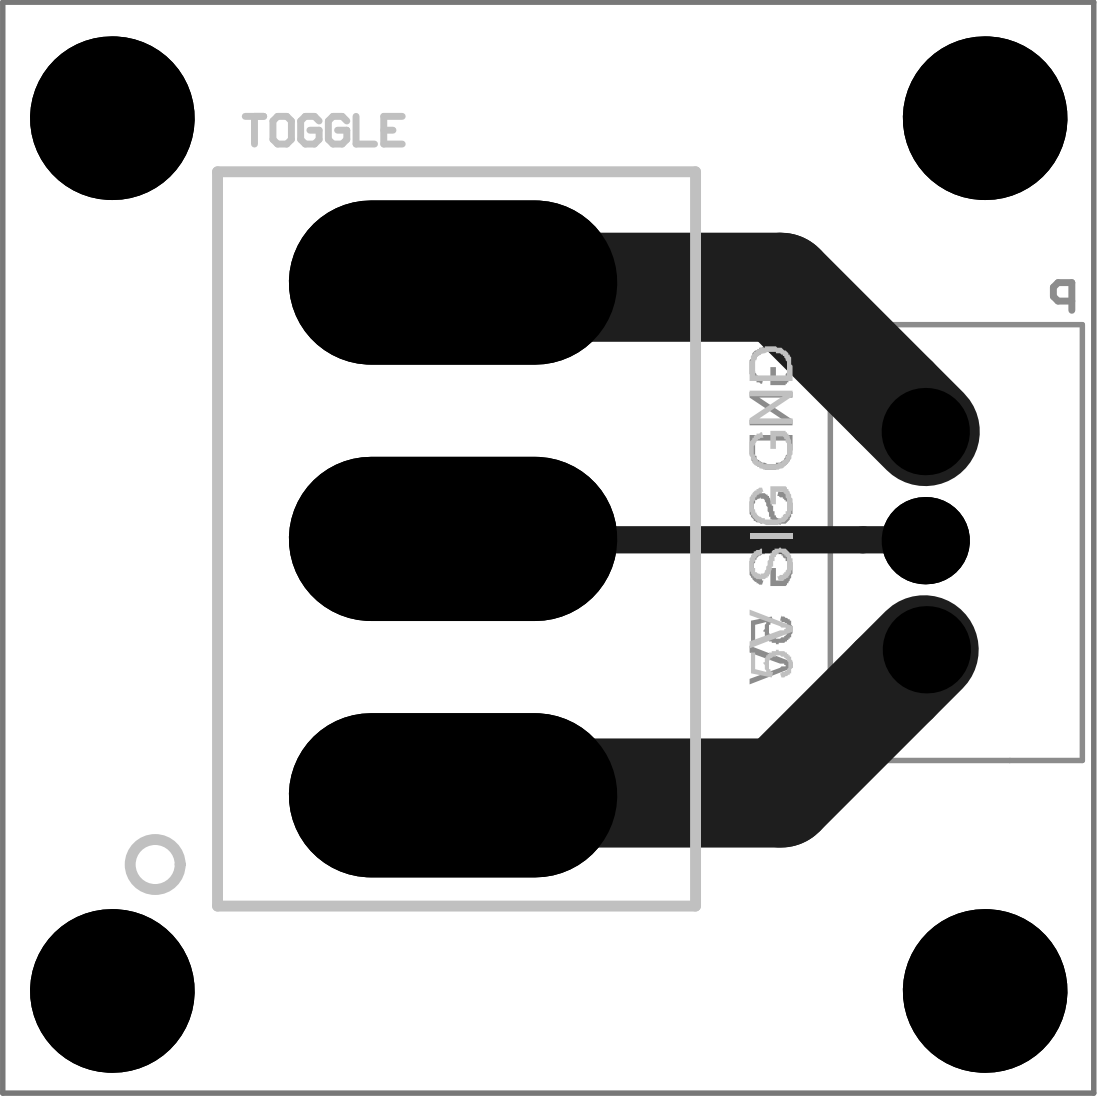
[picture p18: page 2]
