TechhouseDragon/NC-1-/(list of files, drawings)

Other design files:
PCB/Button/button.PcbDoc
PCB/Button/button.PrjPcb
PCB/Button/button.SchDoc
PCB/Button/PcbLib.PcbLib
PCB/Button/Schlib.SchLib
PCB/LEDController_NC-1/LEDController.SchDoc
PCB/LEDController_NC-1/LEDController_NC-1.PrjPcb
PCB/LEDController_NC-1/PcbLib1.PcbLib
PCB/LEDController_NC-1/PcbLib.PcbLib
PCB/LEDController_NC-1/PowerSupply.SchDoc
PCB/LEDController_NC-1/Rotary.SchDoc
PCB/LEDController_NC-1/Schlib.SchLib
PCB/STROBE/Schlib.SchLib
PCB/STROBE/Strobe.PcbDoc
PCB/STROBE/Strobe.PrjPcb
PCB/STROBE/Strobe.SchDoc
PCB/Toggle/PcbLib.PcbLib
PCB/Toggle/Schlib.SchLib
PCB/Toggle/Toggle.PcbDoc
PCB/Toggle/Toggle.PrjPcb
PCB/Toggle/Toggle.SchDoc
