TechhouseDragon/NC-1-/Firmware/NC-1_V2.4/functions.ino

int rowShift;
int colShift;
//SET OUTPUT Array
void setOutputArray(){
    //LAY THE FRAME ARRAY OVER THE LED ARRAY
  for (row = 0; row < numRows; row++){
    for (col = 0; col < numCols; col++){
      WriteBit(col, row, "LEDArray", ReadBit(col, row, "patternArray"));
   //   LEDArray[col][row] = patternArray[col][row];
    }
  }
  //UPDATE THE GLOW ARRAY
  for (row = 0; row <numRows; row++){
    for (col = 0; col < numCols; col++){      
      glowArray [col][row]= glowArray[col][row]*glow ;            
     // glowArray [col][row] = glowArray[col][row]+LEDArray[col][row];
      glowArray [col][row] = glowArray[col][row]+ ReadBit(col, row, "LEDArray");// bitRead(LEDArray[divi(col,  row ,numCols)], modi(col, row, numCols));
      if (ReadBit(col, row, "LEDArray") == 1 ){
        colourArray[col][row] [r] = redintensity;
        colourArray[col][row] [g] = greenintensity;
        colourArray[col][row] [b] = blueintensity;
      }
    }
  }
}
void setshift(){

  //East  
  if (dir == 1){  
    colShift = 1;
    rowShift = 0;
  }
  //North  
  if (dir == 2){
    colShift = 0;
    rowShift = 1;
  }
  //West  
  if (dir == 3){
    colShift = -1;
    rowShift = 0;
  }
  //South  
  if (dir == 4){
    colShift = 0;
    rowShift = -1;
  }
  //NE
  if (dir == 5){
    colShift = 1;
    rowShift = 1;
  }
  //NW
  if (dir == 6){
    colShift = -1;
    rowShift = 1;
  }
  //SW
  if (dir == 7){
    colShift = -1;
    rowShift = -1;
  }
  //SE
  if (dir == 8){
    colShift = 1;
    rowShift = -1;
  }  
}
void setshift2(){

  //East  
  if (dir == 0){  
    colShift = colShift+1;
  }

  //NE
  else if (dir == 1){
    colShift = colShift+1;
    rowShift = rowShift+1;
  }
  
  //North  
  else if (dir == 2){
    rowShift = rowShift+1;
  }
  
  //NW
  else if (dir == 3){
    colShift = colShift-1;
    rowShift = rowShift+1;
  }
  
  //West  
  else if (dir == 4){
    colShift = colShift-1;
  }
    //SW
  else if (dir == 5){
    colShift = colShift-1;
    rowShift = rowShift-1;
  }
  
  //South  
  else if (dir == 6){
    rowShift = rowShift-1;
  }

  //SE
  else if (dir == 7){
    colShift = colShift+1;
    rowShift = rowShift-1;
  } 

}
int trigger(){

  //READ AND AVERAGE SPEED KNOB INPUT
  speedinput = analogRead(BPMPin);
   speedinput = map(speedinput, 0, 1023, 1023, 0);
  // subtract the last reading:
  Stotal= Stotal - Sreadings[Sindex];         
  // read from the sensor:  
  Sreadings[Sindex] = speedinput; 
  // add the reading to the total:
  Stotal= Stotal + Sreadings[Sindex];       
  // advance to the next position in the array:  
  Sindex = Sindex + 1;                    
  // if we're at the end of the array...
  if (Sindex >= numReadings)              
    // ...wrap around to the beginning: 
    Sindex = 0; 
  // calculate the average:
  Saverage = Stotal / numReadings;
  loopspeed = 200/(Saverage/1023);
  if (digitalRead(Speed1)==1 && (digitalRead(Speed2)==0) && (digitalRead(Speed3)==0)){
    loopspeed = loopspeed * 4;
  }
  if (digitalRead(Speed1)==1 && (digitalRead(Speed2)==1) && (digitalRead(Speed3)==0)){
    loopspeed = loopspeed * 2;
  }
  if (digitalRead(Speed1)==0 && (digitalRead(Speed2)==1) && (digitalRead(Speed3)==1)){
    loopspeed = loopspeed / 2;
  }
  if (digitalRead(Speed1)==0 && (digitalRead(Speed2)==0) && (digitalRead(Speed3)==1)){
    loopspeed = loopspeed / 4;
  }
  //Serial.print("loopspeed:    ");
  //Serial.print(loopspeed);

  telapsed = millis()-lastTrigger;
  if (telapsed >= loopspeed) {
    triggernow = 1;
    lastTrigger = millis();
  }
  return triggernow;
} 

//GLOW ENGINE
void setglow(){

  //READ AND AVERAGE COLOR GLOW INPUT
  glowinput = analogRead(GlowPin);
  glowinput = map(glowinput, 0, 1023, 1023, 0);
  // subtract the last reading:
  Gtotal= Gtotal - Greadings[Gindex];         
  // read from the sensor:  
  Greadings[Gindex] = glowinput; 
  // add the reading to the total:
  Gtotal= Gtotal + Greadings[Gindex];       
  // advance to the next position in the array:  
  Gindex = Gindex + 1;                    
  // if we're at the end of the array...
  if (Gindex >= numReadings)              
    // ...wrap around to the beginning: 
    Gindex = 0; 
  // calculate the average:
  Gaverage = Gtotal / numReadings;
  glow = (Gaverage/1023);
  glow = constrain(glow, 0, 1023); 
}
//SET PATTERN MODES and Looptime
void setmode(){
   int val = analogRead(modePin); 
   digitalWrite(resetPin1, HIGH);
   digitalWrite(resetPin2, HIGH);
   int tmp =10 -val/100;
   mode = tmp;
   int val1 = analogRead(loopsPin);  
   int tmp1 = 10- val1/100;
   mode2 = tmp1;  
  
  if(mode == 0) Mode_LED(10, mode2);
  else Mode_LED(mode, mode2); 
}

void Mode_LED(int mode_number, int loop_number)
{ 
  int first, second, third;
  first = 0;
  second = 0; 
  third = 0;
  if(mode_number <= 2){
    second = pow(2, mode_number-1);
    if(loop_number <= 6){
      loop_number = loop_number+2;
      third = pow(2, loop_number-1)+1;    
    }
    else if(loop_number>6 && loop_number<= 8)
    {
      loop_number = loop_number - 6;
      first =   pow(2, loop_number-1);
    }else if(loop_number>8 && loop_number<= 10)
    {
      loop_number = loop_number - 6;
      first = pow(2, loop_number-1)+1;
    }
  }      
  else if(mode_number >2 && mode_number <=8){     
      second = pow(2, mode_number-1)+1;
    if(loop_number <= 6){
      loop_number = loop_number+2;
      third = pow(2, loop_number-1)+1;    
    }
    else if(loop_number>6 && loop_number<= 8)
    {
      loop_number = loop_number - 6;
      first =   pow(2, loop_number-1);
    }else if(loop_number>8 && loop_number<= 10)
    {
      loop_number = loop_number - 6;
      first = pow(2, loop_number-1)+1;
    }      
  }
  else if(mode_number>8 && mode_number<= 10)
  {
    mode_number = mode_number-8;
   third = pow(2, mode_number-1);
   if(loop_number <= 6){
      loop_number = loop_number+2;
      third = third + pow(2, loop_number-1)+1;    
    }
    else if(loop_number>6 && loop_number<= 8)
    {
      loop_number = loop_number - 6;
      first = pow(2, loop_number-1);
    }else if(loop_number>8 && loop_number<= 10)
    {
      loop_number = loop_number - 6;
      first = pow(2, loop_number-1)+1;
    }  
  }
      digitalWrite(latchPin2, LOW);
      shiftOut(dataPin2, clockPin2, MSBFIRST,first);
      shiftOut(dataPin2, clockPin2, MSBFIRST,second);
      shiftOut(dataPin2, clockPin2, MSBFIRST, third);
      digitalWrite(latchPin2, HIGH);
}
