TechhouseDragon/NC-1-/Firmware/NC-1_V2.4/patternSpots.ino

void patternSpots(){
  int a;
  float angle;
  int rippleCol;
  int rippleRow;
  int currentCol;
  int currentRow;
  int numLoops = 32;
  //check if this is the first time through the pattern
  if (lastPattern != currentPattern){
    seed = 1;
  }

  //seed the pattern - random drop
  if (seed == 1){  
    maxRadius =  mode;
    dropCol=int(random(numCols));
    dropRow=int(random(numRows));
    rippleRadius = mode2 ;
    seed = 0;
    lastPattern = currentPattern;
    loopCount = loopCount +1;
  }



  for (angle = 0; angle<= 360; angle = angle+15){
    currentCol = rippleRadius * cos( angle * PI /180 ); //scaled for the spots pattern
    currentRow = rippleRadius * sin( angle * PI /180 ); //scaled for the spots pattern

    rippleCol = dropCol + currentCol;
    rippleRow = dropRow + currentRow;

    //  add ripple to the patternArray
    if(loopCount %2){
          if ( (rippleCol>=0) &&  (rippleCol< numCols) && (rippleRow>=0) && (rippleRow < numRows )){
            WriteBit(rippleCol, rippleRow, "patternArray", 1);
       }
    }
  }



setOutputArray();

  // clear the current pattern array
  memset(patternArray,0,sizeof(patternArray)); 
  triggernow = 0;

  if(rippleRadius < maxRadius)
    rippleRadius = rippleRadius +1; 
  else
    rippleRadius = rippleRadius -1; 

  if (rippleRadius == maxRadius){
    currentPattern = currentPattern +1;
    seed = 1;
  } 
  
}    
