TechhouseDragon/NC-1-/(commit log)

2022-01-26 NC-1 new Firmware
    - Update the Pattern Select
    [Bill of Materials-LEDController_NC-1.xls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]
2022-01-26 NC-1 Firmware
    - Fix the Glow array.
    [FastLED_Fixed_V2.ino, functions.ino]
2022-01-28 NC-1 Firmware
    Fix the Pallet Button
    Fix the mode/loop button
    [FastLED_Fixed_V2.ino, colour.ino, patternAnglezips.ino, patternClouds.ino, patternDots.ino, patternDrivingrain.ino, patternOrbits.ino, patternPinball.ino]
2022-01-29 NC-1_V2.1
    - Fix the Mode LED blinking.
    [colour.ino, functions.ino, patternAllon.ino, patternAnglezips.ino, patternBox.ino, patternCentreZips.ino, patternClouds.ino, patternDiamond.ino]
2022-01-29 NC-1 V2.1
    Change the main loop
    - currentpattern and seed.
    - change the pattern led to red.
2022-02-02 NC-1 V2.1
    - Update the WriteLED
    - Fix the Strobe, Speed, pattern pause issues.
    [patternFlash.ino, writeLEDArray.ino]
2022-05-08 Add the NC-1 sub PCBs
    [Bill of Materials-Strobe.xls, Bill of Materials-Toggle.xls, Bill of Materials-button.xls, PcbLib.PcbLib, Pick Place for Strobe.csv, Pick Place for Toggle.csv, Pick Place for button.csv, Schlib.SchLib]
2022-05-18 NC-1 Firmware Update
    - Add the Auto pattern
    V2.4
    [case.STEP, pcb.DXF]
